GitYun/Hearing-Aid/README.md

## This is a simple DIY hearing aid, but it can be more than just a hearing aid. You can also convert it into an audio amplifier.   
#### If you have any suggestions or questions, please send an email to
#### youneihai@126.com or youneihai@gmail.com
