GitYun/Hearing-Aid/Dev-doc/wm8974截图/WM8974.pdf

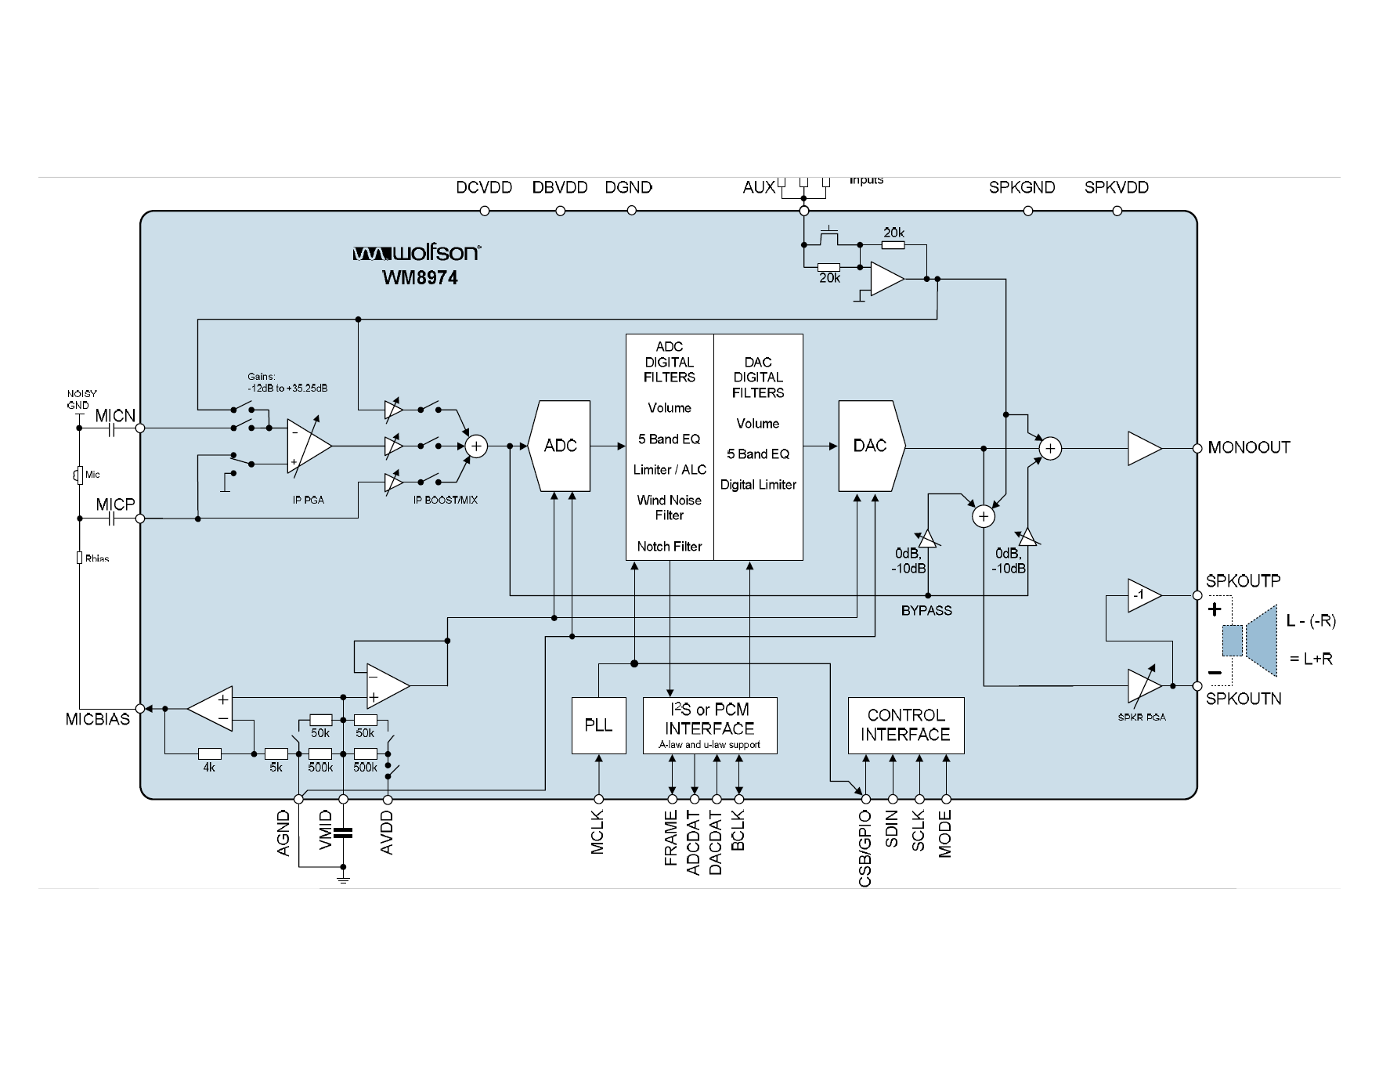
[picture p1: page 1]
