GitYun/Hearing-Aid/Dev-doc/原理图/pcb.pdf

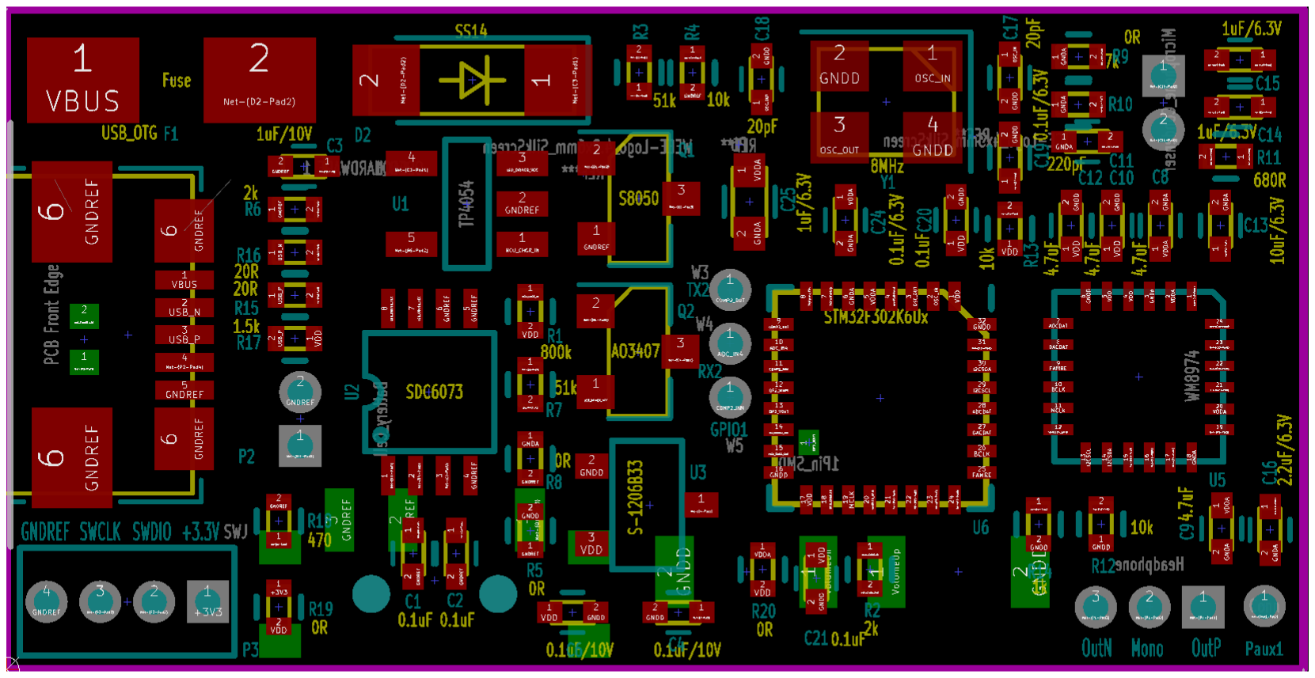
[picture p2: page 1]
