GitYun/Hearing-Aid/Dev-doc/wm8974截图/Registers Map.png

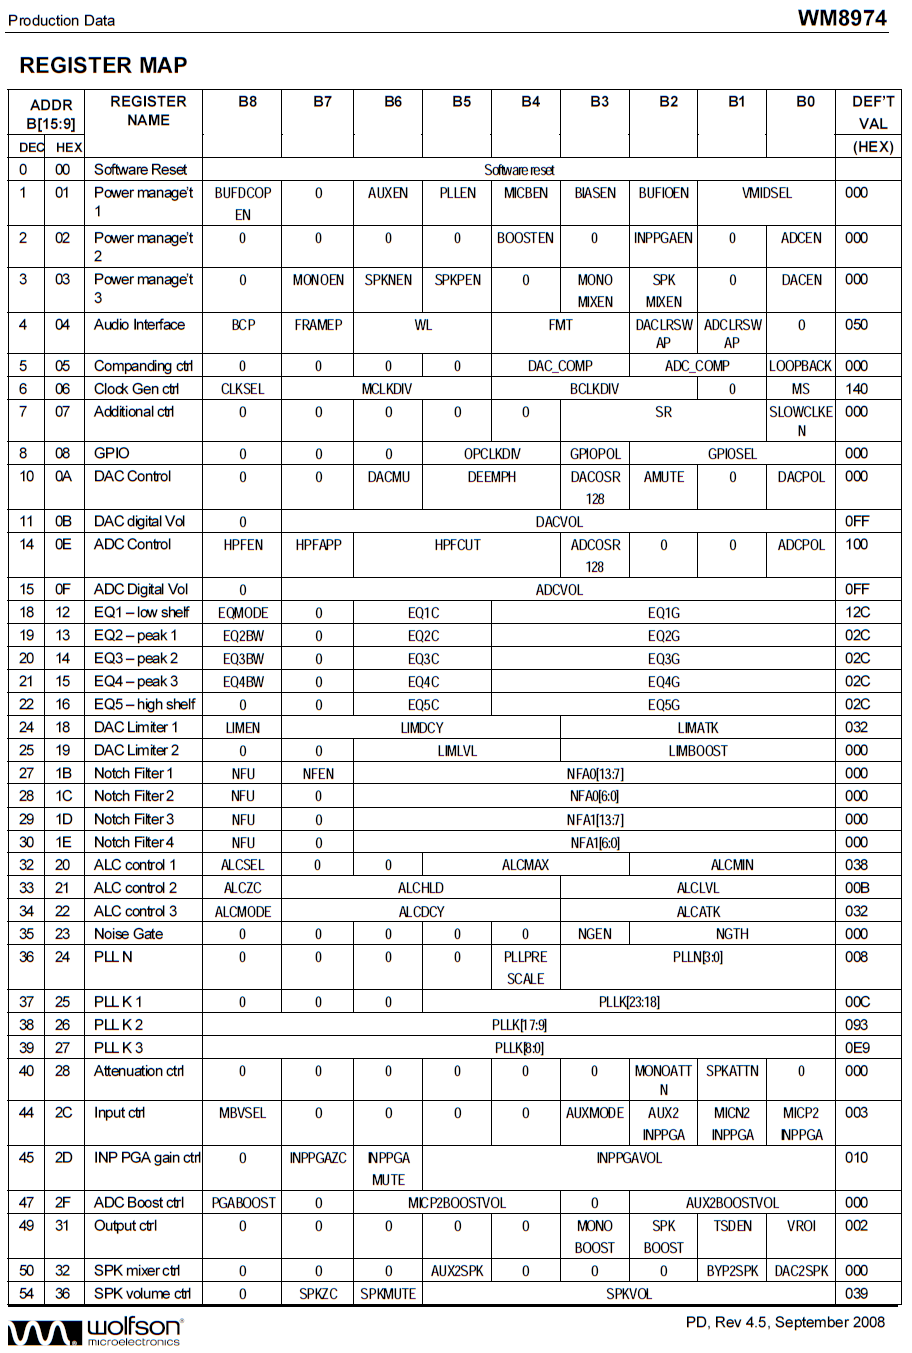
Dev-doc/wm8974截图/Registers Map.png
