GitYun/Hearing-Aid/Dev-doc/wm8974截图/WM8974.png

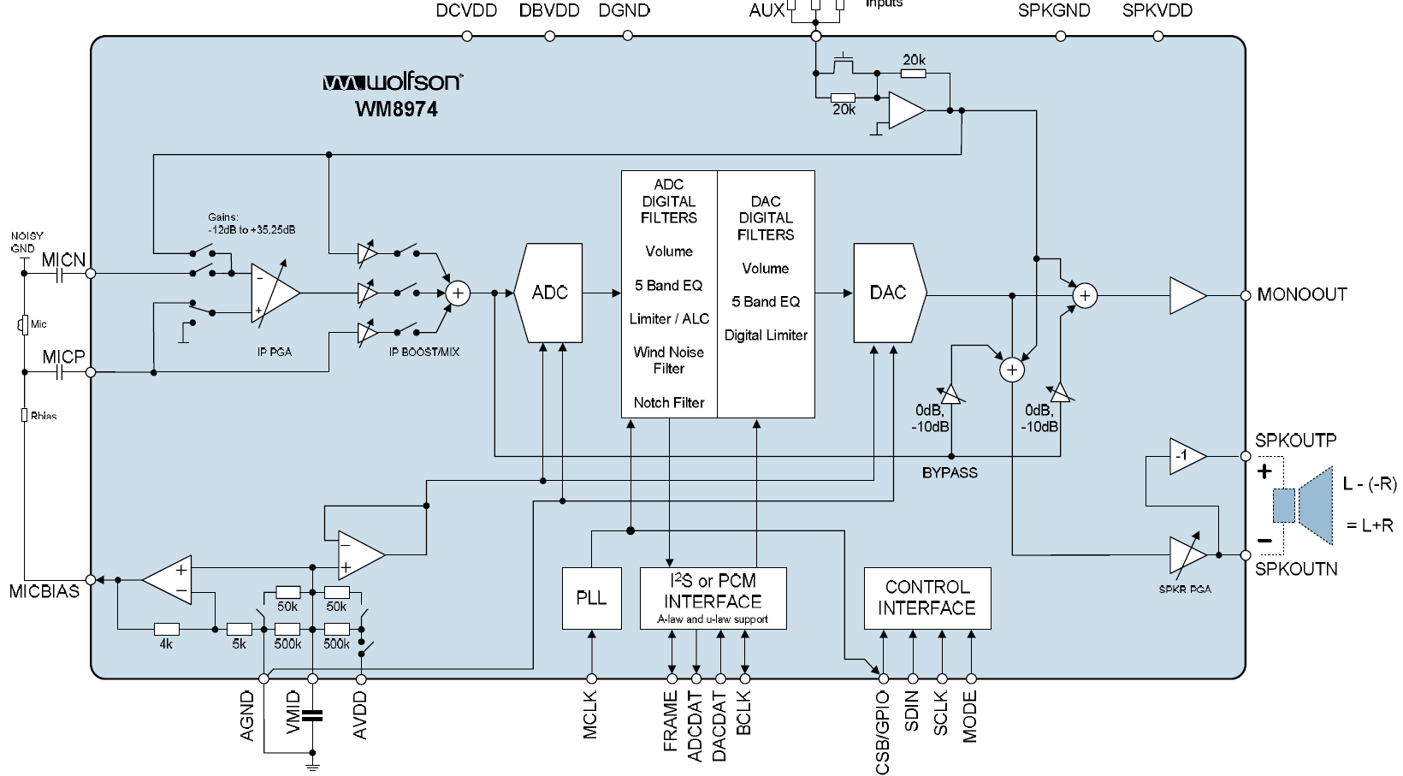
Dev-doc/wm8974截图/WM8974.png
