GitYun/Hearing-Aid/Dev-doc/原理图/helpPCB.pdf

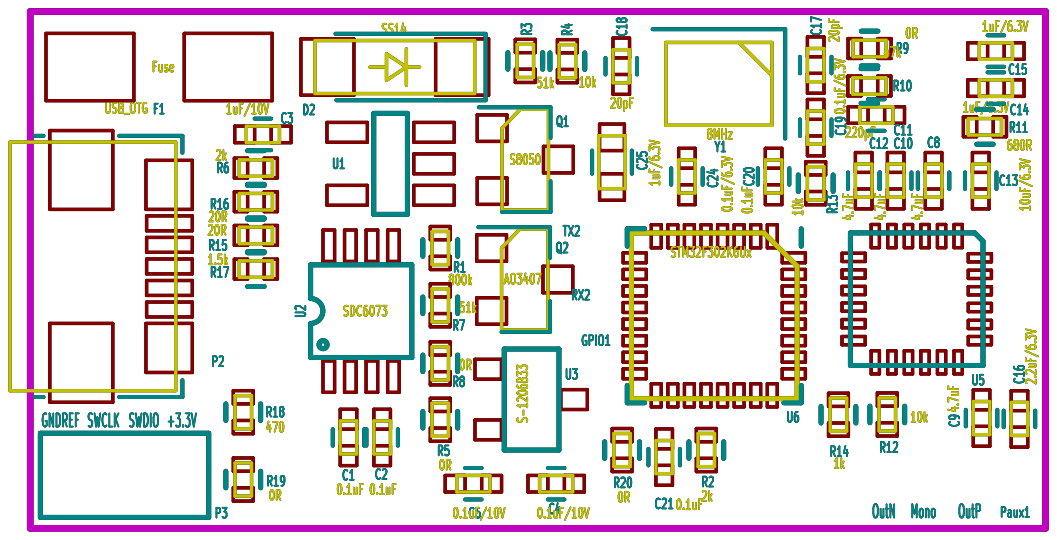
[picture p5: page 1]
