GitYun/Hearing-Aid/Dev-doc/原理图/topwire_pcb.pdf

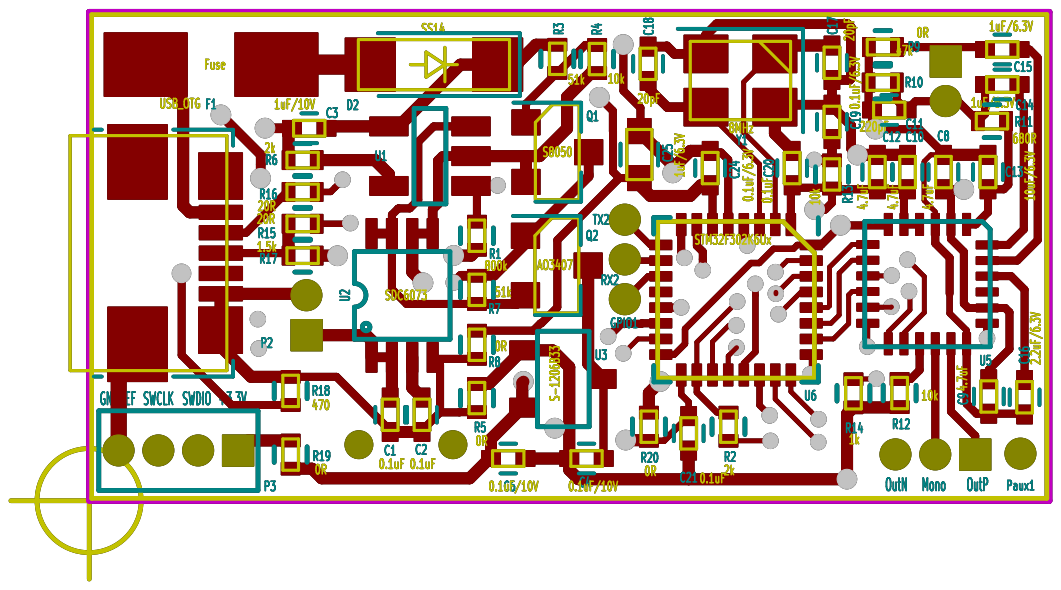
[picture p10: page 1]
