GitYun/Hearing-Aid/hearing aid.ioc

Mcu.UserName=STM32F302K8Ux
PA0.GPIO_Label=VOL_UP
PA0.Signal=GPIO_Input
PA1.GPIO_Label=VOL_DN
PA1.Signal=GPIO_Input
PA10.GPIO_Label=WMIO_GPIO_EXTI10
PA10.Signal=GPXTI10
PA11.Signal=USB_DM
PA12.Signal=USB_DP
PA13.Signal=SYS_JTMS-SWDIO
PA14.Signal=SYS_JTCK-SWCLK
PA15.Signal=I2S3_WS
PA2.Signal=USART2_TX
PA3.Signal=USART2_RX
PA7.GPIO_Label=BAT_LED
PA7.Signal=GPIO_Output
PA8.GPIO_Label=CHRG_IN
PA8.Signal=GPIO_Input
PA9.Signal=I2S3_MCK
PB0.GPIO_Label=CHRG_OUT
PB0.Signal=GPIO_Output
PB3.Signal=I2S3_CK
PB4.Signal=I2S3_ext_SD
PB5.Signal=I2S3_SD
PB6.Signal=I2C1_SCL
PB7.Signal=I2C1_SDA
PF0-OSC_IN.Signal=RCC_OSC_IN
PF1-OSC_OUT.Signal=RCC_OSC_OUT
