GitYun/Hearing-Aid/Drivers/Keys/keys.h

// Header:
// File Name: 
// Author:
// Date:

#ifndef KEYS_H
#define KEYS_H

#ifdef __cplusplus
extern "C" {
#endif

#include "stm32f3xx_hal.h"

void keysTaskInit(void);
	
#ifdef __cplusplus
}
#endif

#endif
