GitYun/Hearing-Aid/App/Inc/audioStream.h

// Copyright (c) 2019 Yoki
// Licensed under the MIT License

// Header:
// File Name: audioStream.h
// Author: 		RQY
// Date:			2017-7-22

#ifndef AUDIOSTREAM_H
#define AUDIOSTREAM_H

#ifdef __cpulspuls
extern "C"	{
#endif

#include "stm32f3xx_hal.h"

	
#ifdef __cpulspuls
}
#endif

#endif
