GitYun/Hearing-Aid/(commit log)

2019-05-01 1. 初次提交 2. 充电模块正常工作 3. 音频模块测试中...
2019-05-03 1. 充电模块的LED动作模式，正常（未充电）时，LED亮1s灭1s；欠压时，LED亮250ms， 灭250ms；充电时，LED常亮；充满电时，LED常灭 2. I2C通信已通过测试，HAL的I2C库函数操作时，从机设备地址需要向左移动1bit 因为MCU I2C作为Master时，地址寄存器的最低位不是从机地址 3. 修改WM8974的音量操作代码
2019-05-12 1. 取消ALC控制，在key.c中 2. 更改使用I2C发送控制数据到WM89xx的字节序，高字节在先，WM89xx寄存器地址字节在先 3. 在main.c中加入对WM8974的测试，直接将麦克风的采集增益后送到输出 4. 已完成测试，目前增益最大为：35.25dB(Input GPA Gain) + 20dB(Input PGA Boost Gain) = 55.25dB, 但会啸叫且噪声大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
